xesscorp/XuDL/(notices)

Notices in the files:
firmware/XuDL_user/HardwareProfile.h:
This program is free software; you can redistribute it and/or modify
it under the terms of the GNU General Public License as published by
the Free Software Foundation; either version 2 of the License, or (at
firmware/XuDL_boot/main.c:
modify it under the terms of the GNU General Public License
